onibrow/eecs149-proj/hardware/buck.png

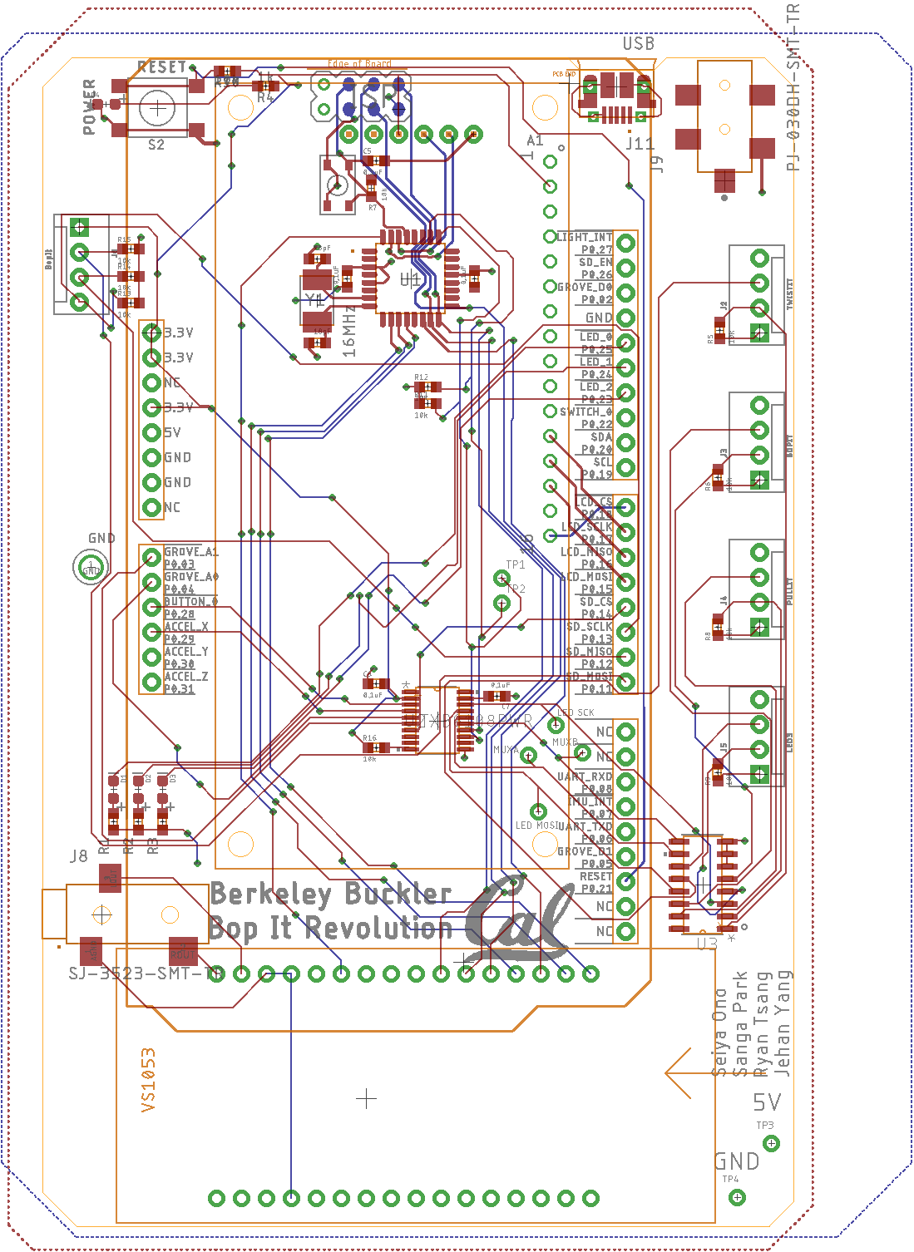
hardware/buck.png
