onibrow/eecs149-proj/hardware/BOM_REV_A.xlsx

Comment | Designator | Footprint | LCSC Part #（optional）
0.1uF | C1, C2, C5, C6, C7 | 0603_C | C14663
18pF | C3, C4 | 0603_C | C1647
10k | R5, R6, R7, R8, R9, R10, R11, R12, R13, R14, R15, R16 | 0603_R | C25804
1k | R1, R2, R3, R4 | 0603_R | C21190
ATMEGA328P | U1 | QFN-44_EP_7x7x0.5P | C14877
Green | D1 | LED_0603 | C72043
Red | D2 | LED_0603 | C2286
Green | D3 | LED_0603 | C72043
Red | D4 | LED_0603 | C2286
