onibrow/eecs149-proj/LED_strip_test/README.md

LED Strip Test
=====

WS2801 LED Strip tests. Currently writing API in order to simplify integration. 
TODO: 
  * Working on muxing between 3 LEDs.
  * Linked list structure used to insert different RGB values at various times for a long song. 

Copied code from SPIM example. 

Reference: SPIM SDK 15.3.0 Driver 
(https://infocenter.nordicsemi.com/topic/com.nordic.infocenter.sdk5.v15.3.0/group__nrfx__spim.html)
