onibrow/eecs149-proj/LED_strip_test/SomeLightsOn.jpg

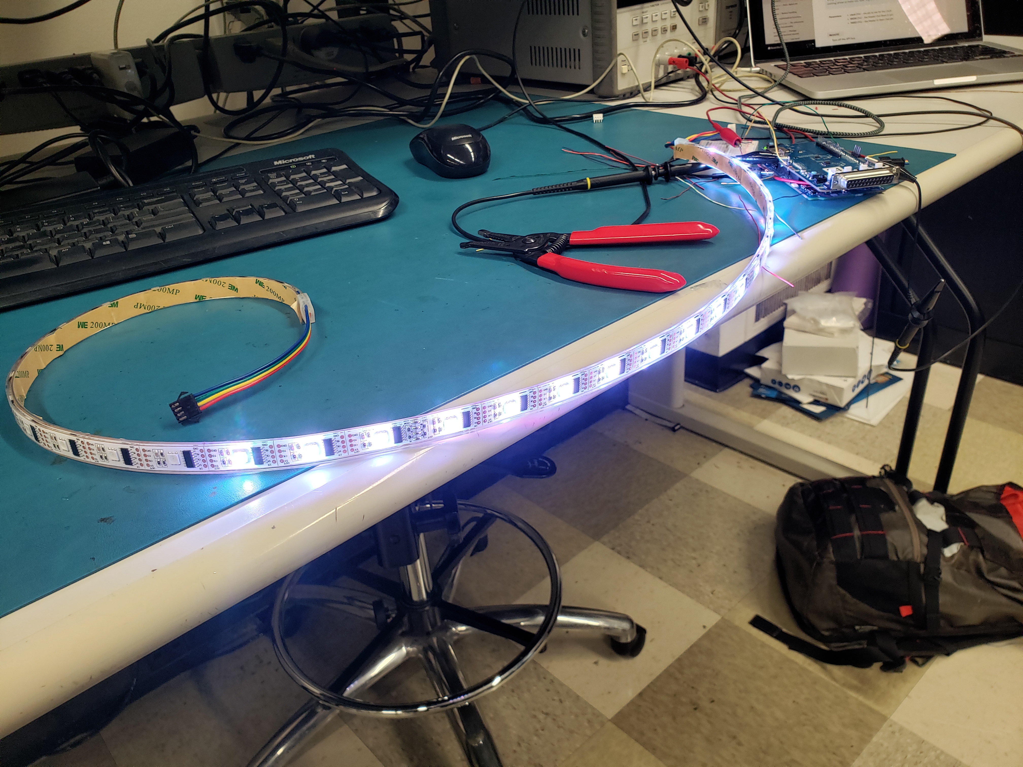
LED_strip_test/SomeLightsOn.jpg
