onibrow/eecs149-proj/hardware/buckler.brd

## EAGLE design hardware/buckler.brd (2019-12-12)

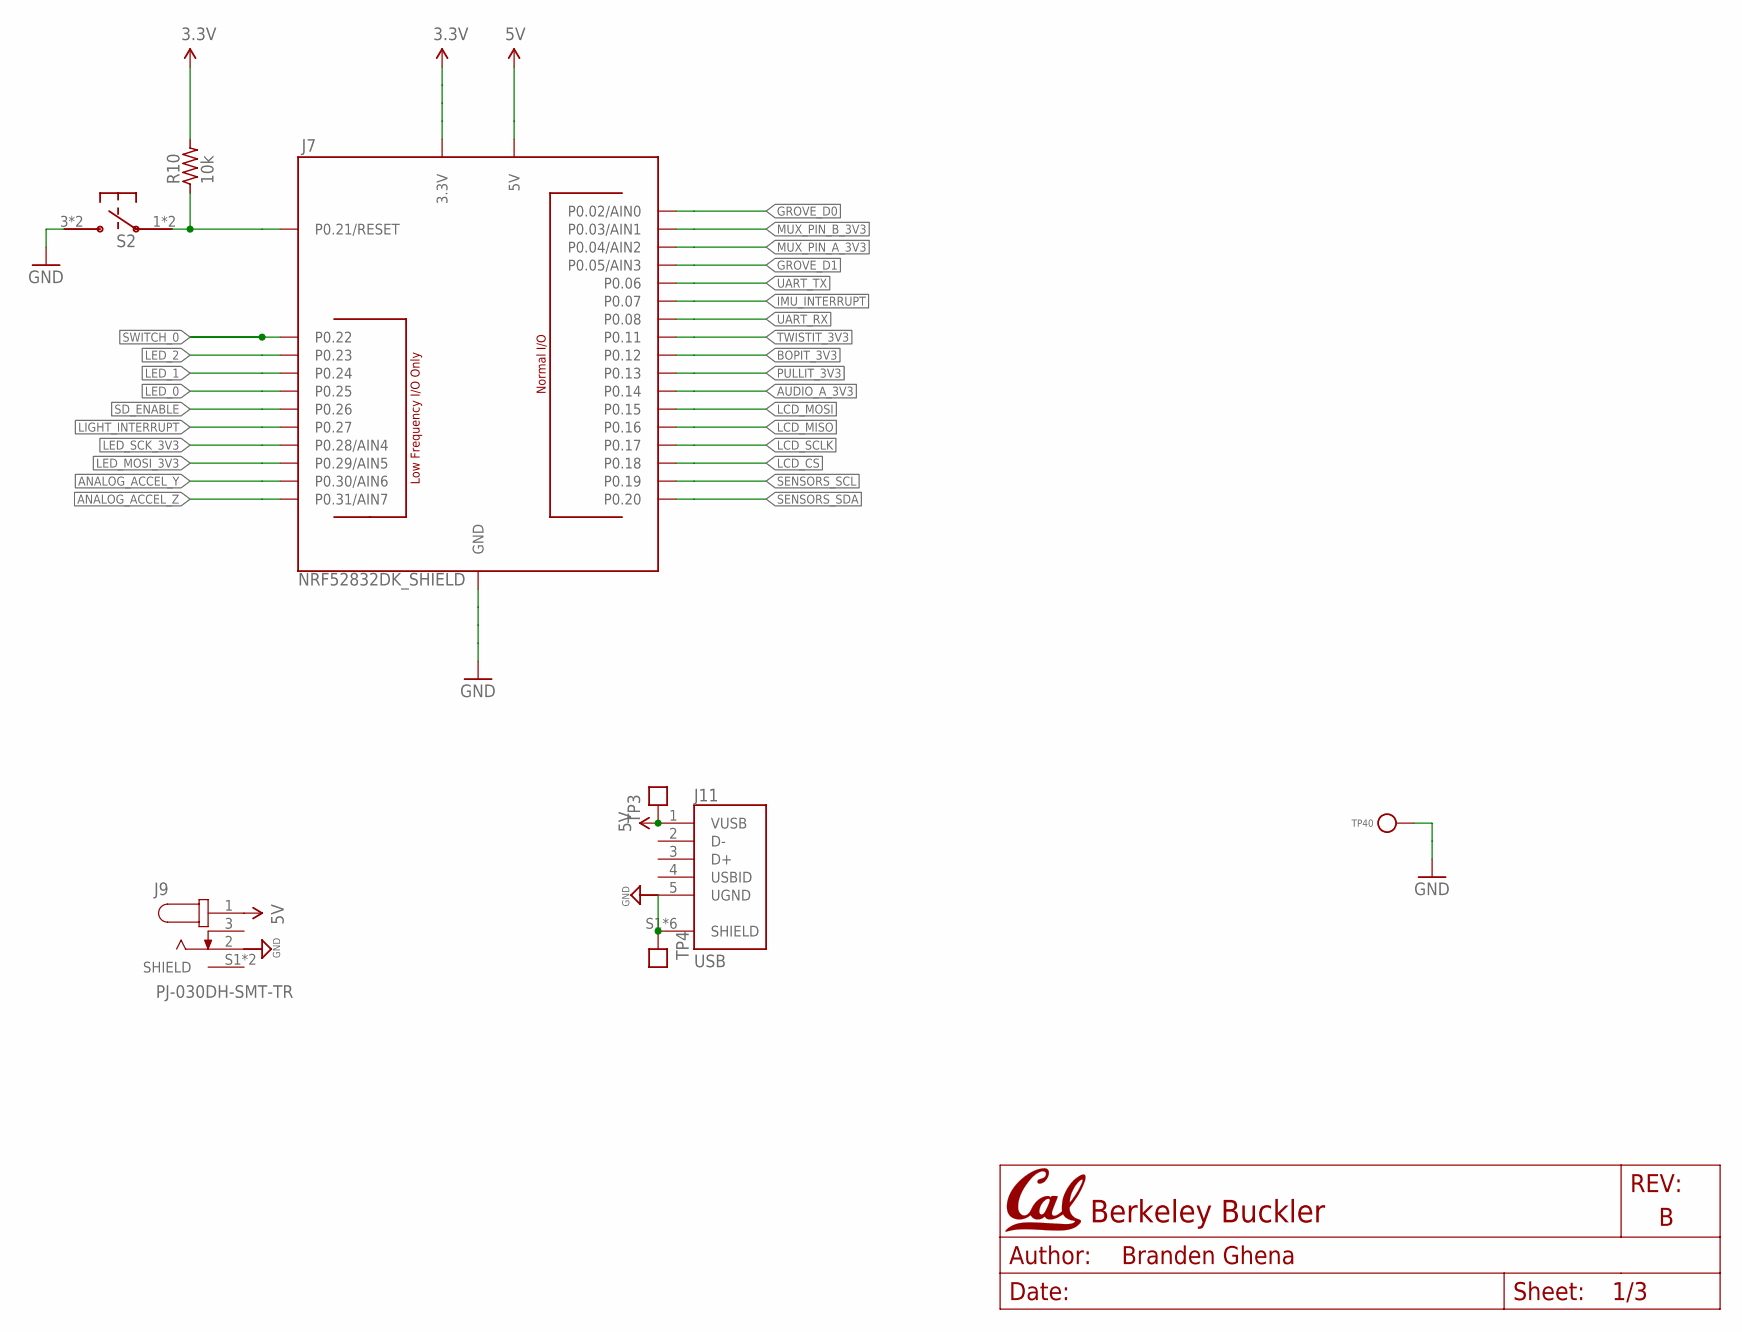
[picture p4: schematic buckler.sch, sheet 1, Headers]

Parts:
J7: NRF52832DK_SHIELD; DIGIKEY1 S1011EC-10-ND
J9: PJ-030DH-SMT-TR; CUI_PJ-030DH-SMT-TR
J11: USB; FCI_10103594-0001LF
R10: 10k; 0603-RES; MPN RC1005F103CS; DIGIKEY 1276-3431-1-ND
S2: PTS645SM43SMTR92; PTS645; MPN PTS645SM43SMTR92 LFS
TP3, TP4: TEST_POINTTHRU; TEST_POINT
TP40: TEST_POINT_0.078IN; TESTPOINT_0.078IN; MPN 1520-2; DIGIKEY 36-1520-2-ND

Connections:
3.3V: J7.3.3V@0 (3.3V), J7.3.3V@1 (3.3V), J7.3.3V@2 (3.3V), R10.2; also elsewhere on the board
5V: J7.5V, J9.1, J11.1 (VUSB), TP3.1; also elsewhere on the board
!IMU_INTERRUPT: J7.P0.07
!LCD_CS: J7.P0.18; also elsewhere on the board
!LED_0: J7.P0.25; also elsewhere on the board
!LED_1: J7.P0.24; also elsewhere on the board
!LED_2: J7.P0.23; also elsewhere on the board
!LIGHT_INTERRUPT: J7.P0.27
!RESET: J7.P0.21 (P0.21/RESET), R10.1, S2.1, S2.2
ANALOG_ACCEL_Y: J7.P0.30 (P0.30/AIN6)
ANALOG_ACCEL_Z: J7.P0.31 (P0.31/AIN7)
AUDIO_A_3V3: J7.P0.14; also elsewhere on the board
BOPIT_3V3: J7.P0.12; also elsewhere on the board
GND: J7.GND@0 (GND), J7.GND@1 (GND), J7.GND@2 (GND), J9.2, J11.5 (UGND), J11.S1 (SHIELD), J11.S2 (SHIELD), J11.S3 (SHIELD), J11.S4 (SHIELD), J11.S5 (SHIELD), J11.S6 (SHIELD), S2.3, S2.4, TP4.1, TP40.1; also elsewhere on the board
GROVE_D0: J7.P0.02 (P0.02/AIN0)
GROVE_D1: J7.P0.05 (P0.05/AIN3)
LCD_MISO: J7.P0.16; also elsewhere on the board
LCD_MOSI: J7.P0.15; also elsewhere on the board
LCD_SCLK: J7.P0.17; also elsewhere on the board
LED_MOSI_3V3: J7.P0.29 (P0.29/AIN5); also elsewhere on the board
LED_SCK_3V3: J7.P0.28 (P0.28/AIN4); also elsewhere on the board
MUX_PIN_A_3V3: J7.P0.04 (P0.04/AIN2); also elsewhere on the board
MUX_PIN_B_3V3: J7.P0.03 (P0.03/AIN1); also elsewhere on the board
PULLIT_3V3: J7.P0.13; also elsewhere on the board
SD_ENABLE: J7.P0.26
SENSORS_SCL: J7.P0.19
SENSORS_SDA: J7.P0.20
SWITCH_0: J7.P0.22
TWISTIT_3V3: J7.P0.11; also elsewhere on the board
UART_RX: J7.P0.08
UART_TX: J7.P0.06

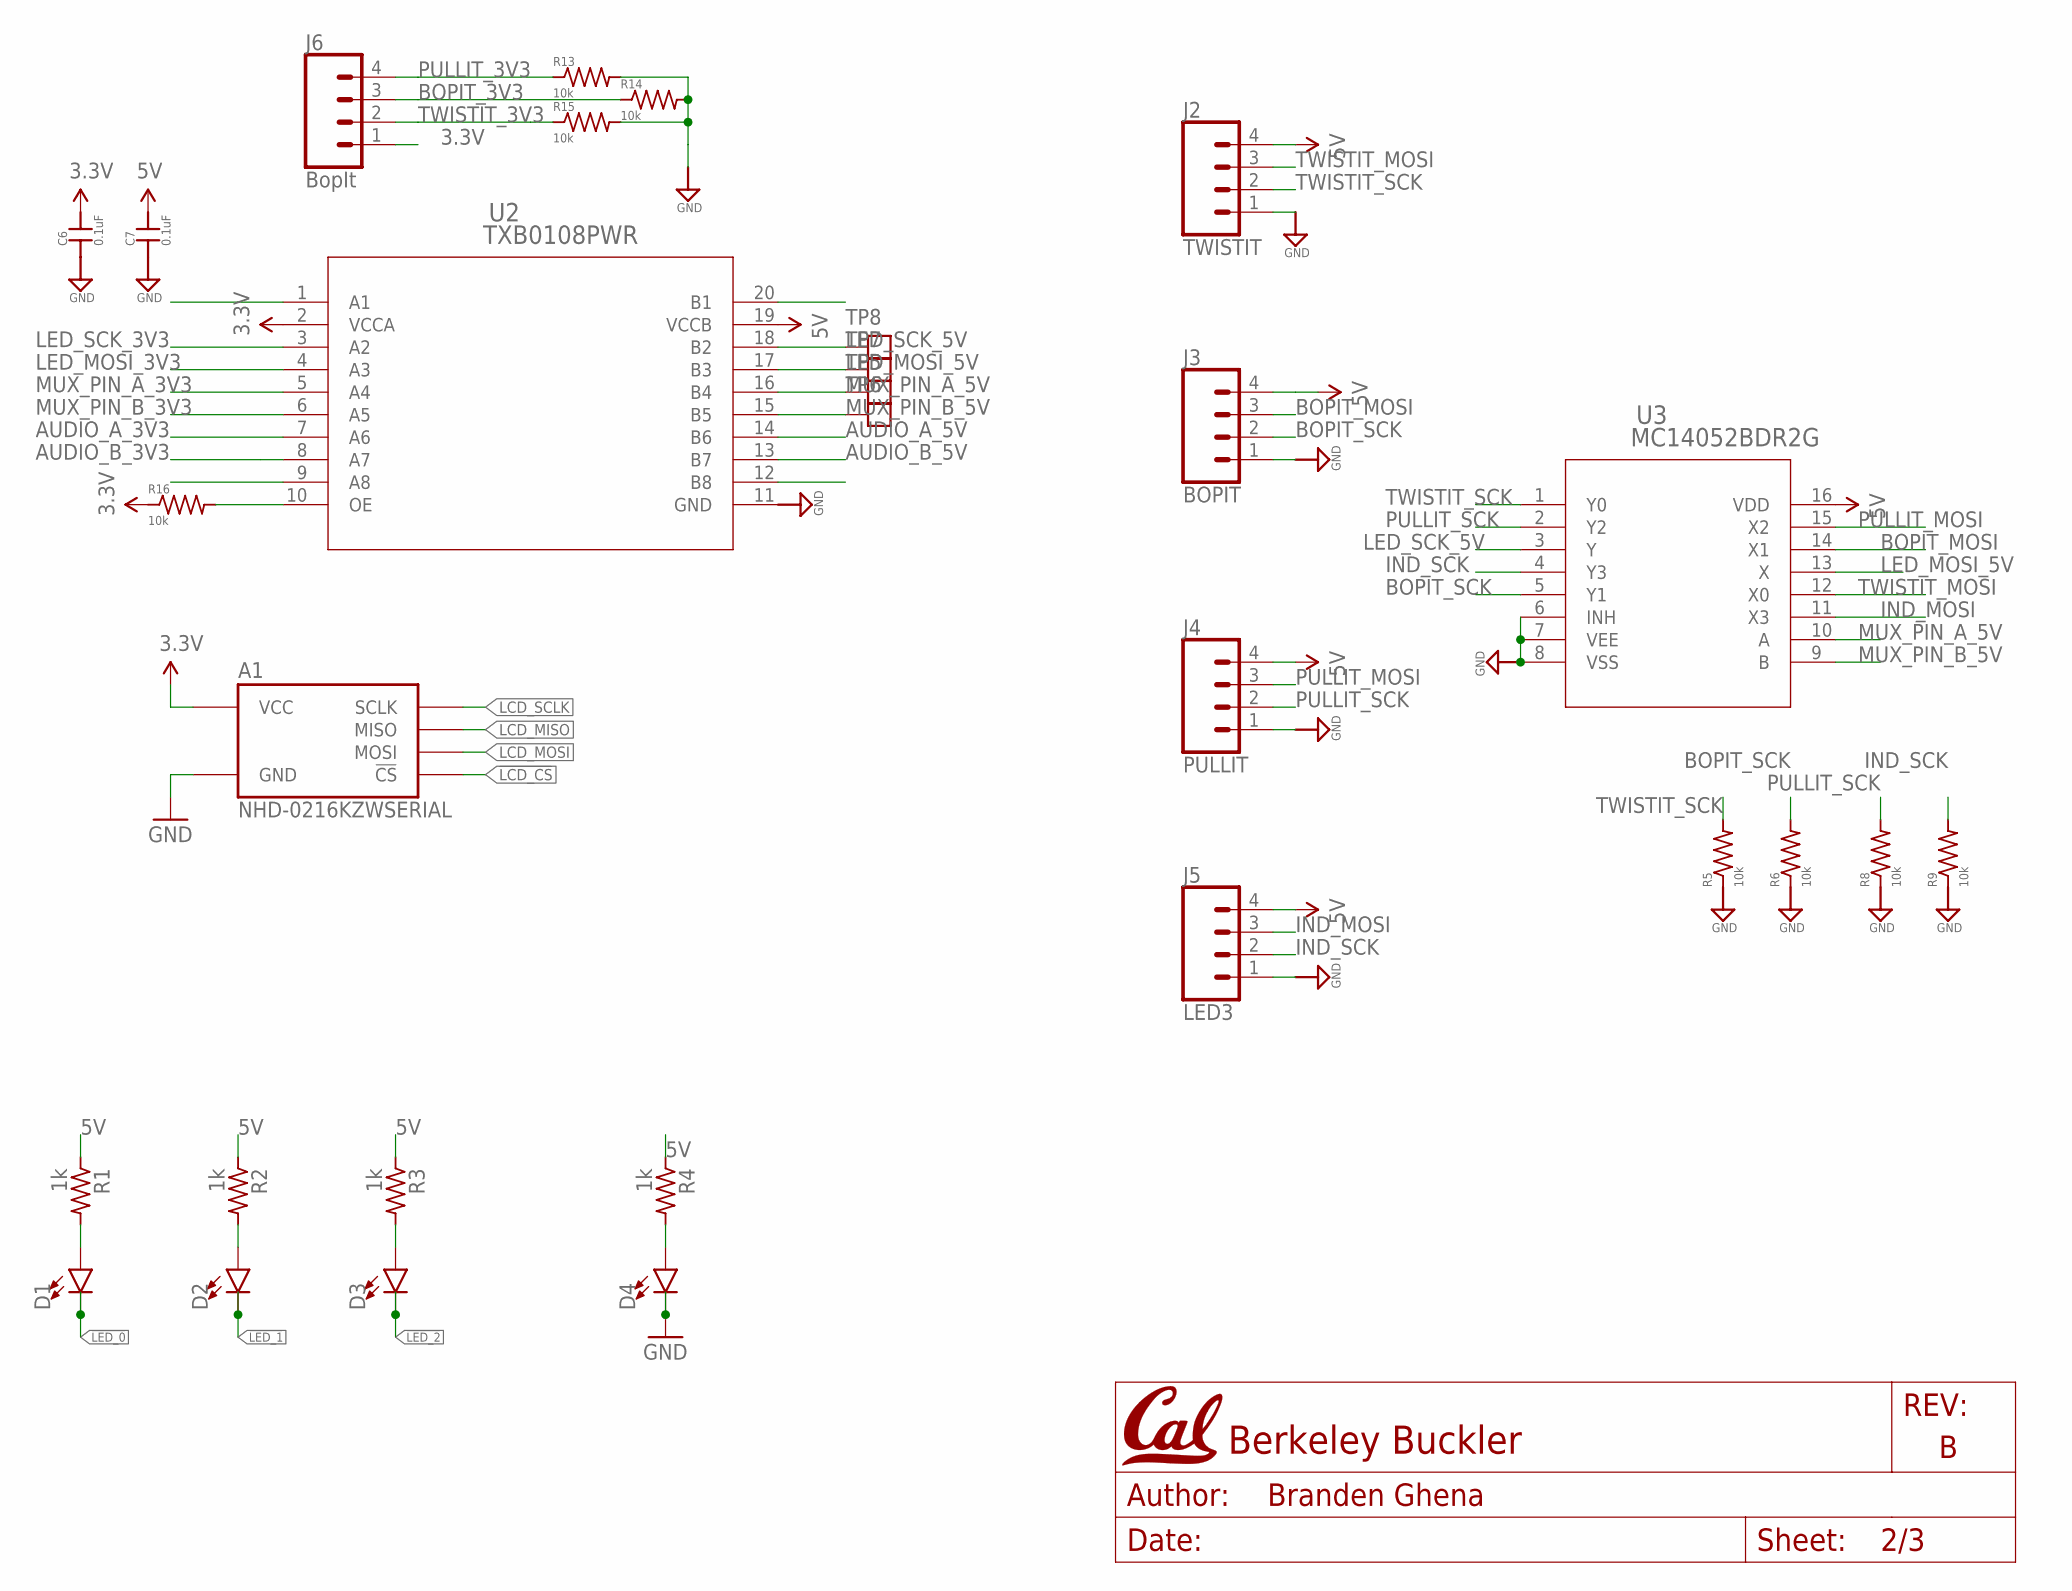
[picture p5: schematic buckler.sch, sheet 2, Other Peripherals]

Parts:
A1: NHD-0216KZWSERIAL; NHD-0216KZW; DIGIKEY1 NHD-0216KZW-AG5-ND
C6, C7: 0.1uF; 0603-CAP
D1, D2, D3, D4: LED0603; LED-0603
J2: TWISTIT; MOLEX-1X4
J3: BOPIT; MOLEX-1X4
J4: PULLIT; MOLEX-1X4
J5: LED3; MOLEX-1X4
J6: BopIt; MOLEX-1X4
R1, R2, R3, R4: 1k; 0603-RES; MPN RMCF0402FT1K00; DIGIKEY RMCF0402FT1K00CT-ND
R5, R6, R8, R9, R13, R14, R15, R16: 10k; 0603-RES
TP5, TP6, TP7, TP8: TEST_POINTTHRU; TEST_POINT
U2: TXB0108PWR; PW20
U3: MC14052BDR2G; SOIC-16

Connections:
3.3V: A1.2 (VCC), C6.2, J6.1, R16.1, U2.2 (VCCA); also elsewhere on the board
5V: C7.2, J2.4, J3.4, J4.4, J5.4, R1.1, R2.1, R3.1, R4.1, U2.19 (VCCB), U3.16 (VDD); also elsewhere on the board
!LCD_CS: A1.16 (!CS); also elsewhere on the board
!LED_0: D1.C; also elsewhere on the board
!LED_1: D2.C; also elsewhere on the board
!LED_2: D3.C; also elsewhere on the board
AUDIO_A_3V3: U2.7 (A6); also elsewhere on the board
AUDIO_A_5V: U2.14 (B6); also elsewhere on the board
AUDIO_B_3V3: U2.8 (A7)
AUDIO_B_5V: U2.13 (B7); also elsewhere on the board
BOPIT_3V3: J6.3, R14.1; also elsewhere on the board
BOPIT_MOSI: J3.3, U3.14 (X1)
BOPIT_SCK: J3.2, R6.2, U3.5 (Y1)
GND: A1.1 (GND), C6.1, C7.1, D4.C, J2.1, J3.1, J4.1, J5.1, R5.1, R6.1, R8.1, R9.1, R13.2, R14.2, R15.2, U2.11 (GND), U3.6 (INH), U3.7 (VEE), U3.8 (VSS); also elsewhere on the board
IND_MOSI: J5.3, U3.11 (X3)
IND_SCK: J5.2, R9.2, U3.4 (Y3)
LCD_MISO: A1.13 (MISO); also elsewhere on the board
LCD_MOSI: A1.14 (MOSI); also elsewhere on the board
LCD_SCLK: A1.12 (SCLK); also elsewhere on the board
LED_MOSI_3V3: U2.4 (A3); also elsewhere on the board
LED_MOSI_5V: TP7.1, U2.17 (B3), U3.13 (X)
LED_SCK_3V3: U2.3 (A2); also elsewhere on the board
LED_SCK_5V: TP8.1, U2.18 (B2), U3.3 (Y)
MUX_PIN_A_3V3: U2.5 (A4); also elsewhere on the board
MUX_PIN_A_5V: TP5.1, U2.16 (B4), U3.10 (A)
MUX_PIN_B_3V3: U2.6 (A5); also elsewhere on the board
MUX_PIN_B_5V: TP6.1, U2.15 (B5), U3.9 (B)
unnamed: R16.2, U2.10 (OE)
unnamed: D4.A, R4.2
unnamed: D3.A, R3.2
unnamed: D2.A, R2.2
unnamed: D1.A, R1.2
PULLIT_3V3: J6.4, R13.1; also elsewhere on the board
PULLIT_MOSI: J4.3, U3.15 (X2)
PULLIT_SCK: J4.2, R8.2, U3.2 (Y2)
TWISTIT_3V3: J6.2, R15.1; also elsewhere on the board
TWISTIT_MOSI: J2.3, U3.12 (X0)
TWISTIT_SCK: J2.2, R5.2, U3.1 (Y0)

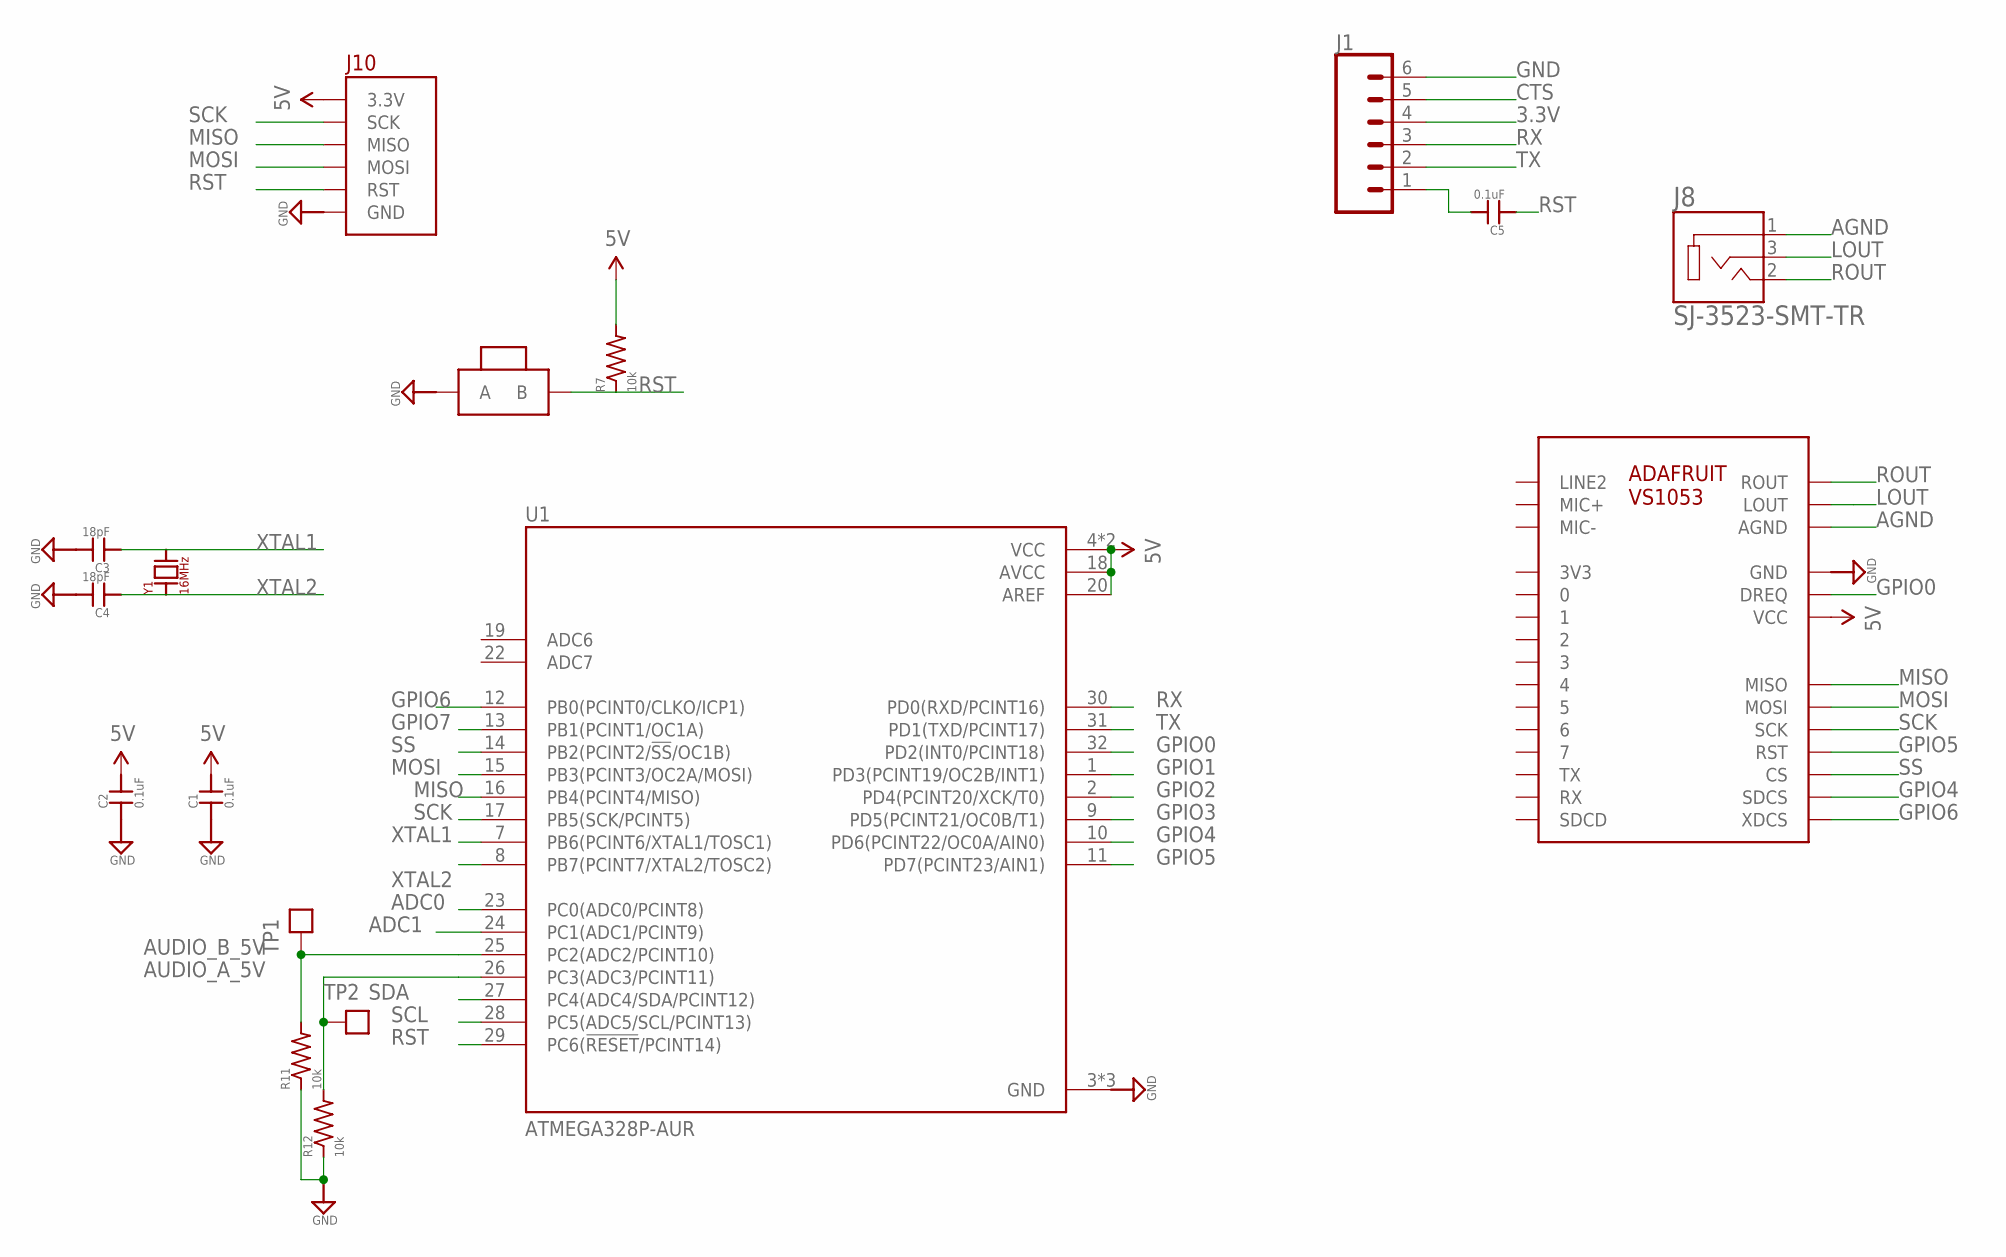
[picture p6: schematic buckler.sch, sheet 3]

Parts:
C1, C2, C5: 0.1uF; 0603-CAP
C3, C4: 18pF; 0603-CAP
J1: CONN_06NO_SILK_FEMALE_PTH; 1X06_NO_SILK
J8: SJ-3523-SMT-TR; CUI_SJ-3523-SMT-TR
J10: BURNIN
R7: 10k; R0603
R11, R12: 10k; 0603-RES
SW1: BTN-PTS810; BTN_PTS810
TP1, TP2: TEST_POINTTHRU; TEST_POINT
U1: ATMEGA328P-AUR; QFP80P900X900X120-32N
U4: ADAFRUIT_VS1053
Y1: 16MHz; XTAL500X320X130N

Connections:
3.3V: J1.4; also elsewhere on the board
5V: C1.2, C2.2, J10.3.3V, R7.2, U1.4 (VCC), U1.6 (VCC), U1.18 (AVCC), U1.20 (AREF), U4.26 (VCC); also elsewhere on the board
ADC0: U1.23 (PC0(ADC0/PCINT8))
ADC1: U1.24 (PC1(ADC1/PCINT9))
AGND: J8.1, U4.4 (AGND), U4.29 (AGND), U4.30 (AGND)
AUDIO_A_5V: R12.2, TP2.1, U1.26 (PC3(ADC3/PCINT11)); also elsewhere on the board
AUDIO_B_5V: R11.2, TP1.1, U1.25 (PC2(ADC2/PCINT10)); also elsewhere on the board
CTS: J1.5
GND: C1.1, C2.1, C3.2, C4.2, J1.6, J10.GND, R11.1, R12.1, SW1.1 (A), SW1.2 (A), U1.3 (GND), U1.5 (GND), U1.21 (GND), U4.24 (GND), U4.28 (GND); also elsewhere on the board
GPIO0: U1.32 (PD2(INT0/PCINT18)), U4.27 (DREQ)
GPIO1: U1.1 (PD3(PCINT19/OC2B/INT1))
GPIO2: U1.2 (PD4(PCINT20/XCK/T0))
GPIO3: U1.9 (PD5(PCINT21/OC0B/T1))
GPIO4: U1.10 (PD6(PCINT22/OC0A/AIN0)), U4.18 (SDCS)
GPIO5: U1.11 (PD7(PCINT23/AIN1)), U4.20 (RST)
GPIO6: U1.12 (PB0(PCINT0/CLKO/ICP1)), U4.17 (XDCS)
GPIO7: U1.13 (PB1(PCINT1/OC1A))
LOUT: J8.3, U4.31 (LOUT)
MISO: J10.MISO, U1.16 (PB4(PCINT4/MISO)), U4.23 (MISO)
MOSI: J10.MOSI, U1.15 (PB3(PCINT3/OC2A/MOSI)), U4.22 (MOSI)
unnamed: C5.2, J1.1
ROUT: J8.2, U4.32 (ROUT)
RST: C5.1, J10.RST, R7.1, SW1.3 (B), SW1.4 (B), U1.29 (PC6(!RESET!/PCINT14))
RX: J1.3, U1.30 (PD0(RXD/PCINT16))
SCK: J10.SCK, U1.17 (PB5(SCK/PCINT5)), U4.21 (SCK)
SCL: U1.28 (PC5(ADC5/SCL/PCINT13))
SDA: U1.27 (PC4(ADC4/SDA/PCINT12))
SS: U1.14 (PB2(PCINT2/!SS!/OC1B)), U4.19 (CS)
TX: J1.2, U1.31 (PD1(TXD/PCINT17))
XTAL1: C3.1, U1.7 (PB6(PCINT6/XTAL1/TOSC1)), Y1.2 (B)
XTAL2: C4.1, U1.8 (PB7(PCINT7/XTAL2/TOSC2)), Y1.1 (A)

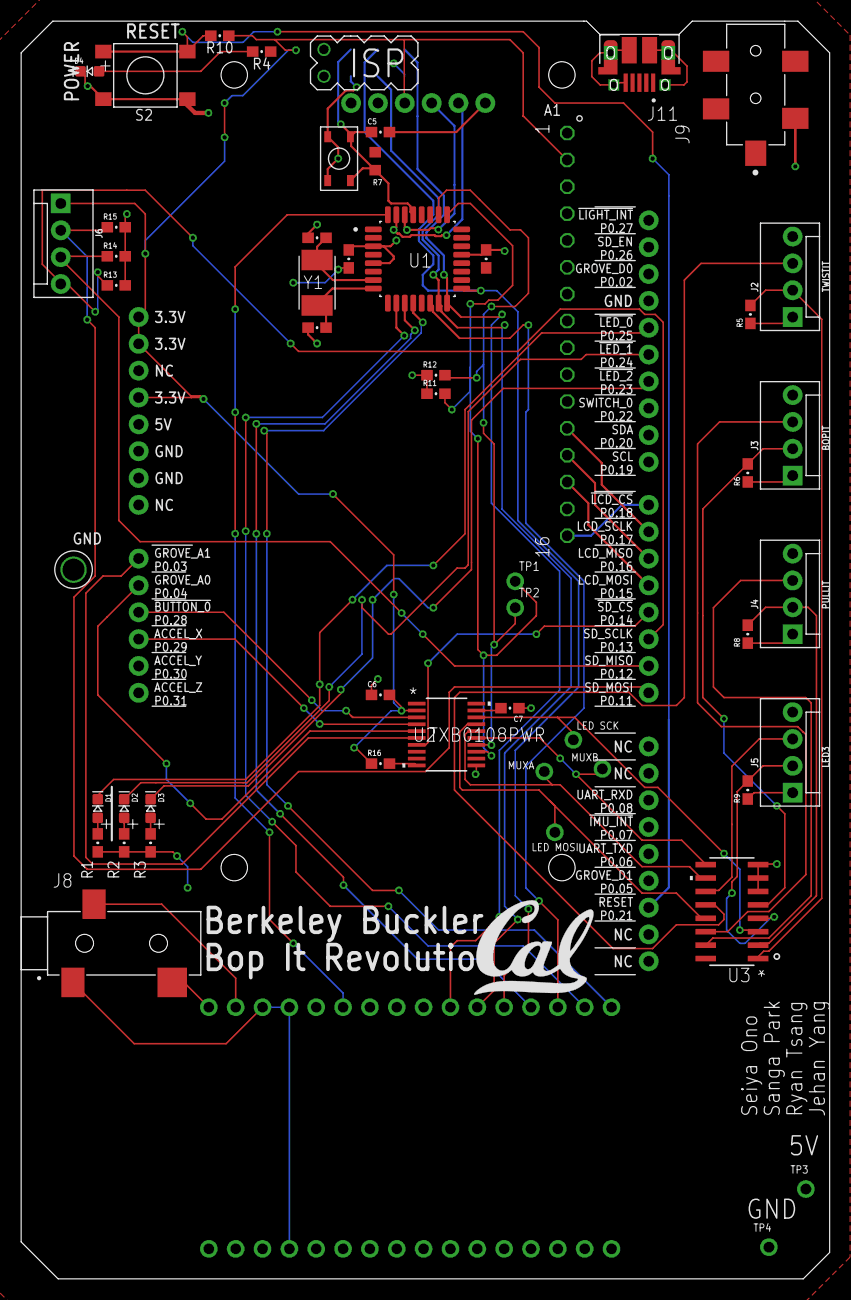
[picture p7: board buckler.brd from above]

Board: 2 copper layers, 76.5 x 119.0 mm, 56 parts (0 on the bottom side), 55 nets.

Other parts of the board:
U$5: UCB_CAL_350MIL
