onibrow/eecs149-proj/vm_setup/app_config.h

// application-specific configuration
// augments the base configuration in sdk/<SDK>/config/<IC>/config/sdk_config.h

#pragma once

#define SIMPLE_BLE_ENABLED 1

#define BLE_ADVERTISING_ENABLED 1
#define NRF_BLE_CONN_PARAMS_ENABLED 1
#define NRF_BLE_GATT_ENABLED 1
#define NRF_BLE_QWR_ENABLED 1
#define BLE_ECS_ENABLED 1

#define BLE_LBS_ENABLED 1
#define BLE_NUS_ENABLED 1

#define NRF_CRYPTO_BACKEND_CIFRA_ENABLED 1
#define NRF_CRYPTO_BACKEND_MBEDTLS_ENABLED 1
#define NRF_CRYPTO_BACKEND_NRF_HW_RNG_ENABLED 1

#define GPIOTE_ENABLED 1
#define GPIOTE_CONFIG_NUM_OF_LOW_POWER_EVENTS 4
#define NRFX_GPIOTE_ENABLED 1

#define NRFX_RNG_ENABLED 1
#define RNG_ENABLED 1

#define NRFX_SAADC_ENABLED 1
#define SAADC_ENABLED 1
#define SAADC_CONFIG_LP_MODE 1

#define NRFX_SPIM_ENABLED 1
#define NRFX_SPIM1_ENABLED 1
#define NRFX_SPI_ENABLED 1
#define NRFX_SPI1_ENABLED 1
#define SPI_ENABLED 1
#define SPI1_ENABLED 1

#define APP_SDCARD_ENABLED 1
#define APP_SDCARD_SPI_INSTANCE 2 // added 
//APP_SDCARD_FREQ_INIT later 

#define NRF_CLOCK_ENABLED 1
#define NRFX_CLOCK_ENABLED 1

#define NRFX_TIMER_ENABLED 1
#define NRFX_TIMER0_ENABLED 1
#define NRFX_TIMER1_ENABLED 1
#define TIMER_ENABLED 1
#define TIMER_DEFAULT_CONFIG_BIT_WIDTH 3
#define TIMER0_ENABLED 1
#define TIMER1_ENABLED 1
#define APP_TIMER_ENABLED 1
#define APP_TIMER_KEEPS_RTC_ACTIVE 1

#define NRFX_UARTE_ENABLED 1
#define NRFX_UART_ENABLED 1
#define UART_ENABLED 1
#define UART0_ENABLED 1
#define APP_UART_ENABLED 1
#define HCI_UART_TX_PIN 6
#define HCI_UART_RX_PIN 8

#define NRFX_TWIM_ENABLED 0  //change it to 1, changed for sd card for now 
#define NRFX_TWI_ENABLED 0
#define TWI_ENABLED 0
#define TWI0_ENABLED 1
#define TWI0_USE_EASY_DMA 1
#define NRF_TWI_MNGR_ENABLED 0

#define APP_FIFO_ENABLED 1
#define APP_SCHEDULER_ENABLED 1

#define CRC16_ENABLED 1

#define NRF_FSTORAGE_ENABLED 1
#define FDS_ENABLED 1
#define FDS_VIRTUAL_PAGES 10
#define FDS_OP_QUEUE_SIZE 10

#define MEM_MANAGER_ENABLED 1

#define NRF_QUEUE_ENABLED 1

#define NRF_PWR_MGMT_ENABLED 1
#define NRF_PWR_MGMT_CONFIG_FPU_SUPPORT_ENABLED 1

#define RETARGET_ENABLED 0

#define BUTTON_ENABLED 1

#define NRFX_PWM_ENABLED 1
#define NRFX_PWM0_ENABLED 1
#define NRFX_PWM1_ENABLED 1
#define NRFX_PWM2_ENABLED 1
#define PWM_ENABLED 1
#define PWM0_ENABLED 1
#define PWM1_ENABLED 1
#define PWM2_ENABLED 1
#define APP_PWM_ENABLED 1
#define LOW_POWER_PWM_ENABLED 1
#define NRFX_PPI_ENABLED 1
#define PPI_ENABLED 1

#define NRF_SECTION_ITER_ENABLED 1

#define NRF_LOG_ENABLED 1
#define NRF_LOG_BACKEND_UART_ENABLED 0
#define NRF_LOG_BACKEND_RTT_ENABLED 1
#define NRF_LOG_USES_RTT 1
#define NRF_LOG_DEFERRED 0
#define NRF_LOG_STR_PUSH_BUFFER_SIZE 128

#define HARDFAULT_HANDLER_ENABLED 1
#define HARDFAULT_HANDLER_GDB_PSP_BACKTRACE 0

#define NRF_SERIAL_ENABLED 1

#define NRF_SDH_ENABLED 1
#define NRF_SDH_BLE_ENABLED 1
#define NRF_SDH_BLE_GAP_DATA_LENGTH 251
#define NRF_SDH_BLE_PERIPHERAL_LINK_COUNT 1
#define NRF_SDH_BLE_GATT_MAX_MTU_SIZE 247
#define NRF_SDH_BLE_VS_UUID_COUNT 10
#define NRF_SDH_SOC_ENABLED 1

// GROUP DEFINED CONFIGS
#define TWI_INSTANCE_ID_USED 0
#define I2S_ENABLED 1
#define NRFX_I2S_ENABLED 1
#define MCP4725_BASE_ADDRESS    0x62        //!< MCP4725 base address

//#define NRFX_SPI_INSTANCE 1
//#define NRFX_SPI_INSTANCE_ID 1
//#define NRF_DRV_SPI_INSTANCE 2

// lots of redundancy, solves not-finding-instance in nrf_drive_spi error 
#define NRFX_SPIM_ENABLED 1
#define NRFX_SPIM0_ENABLED 1
#define NRFX_SPI_ENABLED 1
#define NRFX_SPI0_ENABLED 1
#define SPI_ENABLED 1
#define SPI0_ENABLED 1

//#define NRFX_SPIM_ENABLED 1
#define NRFX_SPIM2_ENABLED 1
#define NRFX_SPI2_ENABLED 1
#define SPI2_ENABLED 1
