onibrow/eecs149-proj/(commit log)

2019-11-08 Add voltage comands
2019-11-14 Fix board mk
2019-11-18 Add includes file and fix sd card pins
    [main.c]
2019-11-18 Add timer
2019-11-20 resolved wrong directory - not compiling issue for SD Card
    [app_config.h]
2019-11-20 SD card now reads, but buffer offset issue exists
    [main.c]
2019-11-20 SD card now reads, but buffer offset issue exists, also TWI disabled
    [app_config.h]
2019-11-21 Added LEDCode Folder with all relevent LED/SPI files
2019-12-05 fix sd card merge conflict
    [LEDStripAPI.c, LEDStripAPI.h, main.c]
2019-12-05 fix sd card conflict
    [main.c]
2019-12-05 clean up code a bit ad fix lsb msb nonsense
    [main.c]
2019-12-05 LED API Works, lightly tested, have not checked for memory leaks
    [LEDStripAPI.c, LEDStripAPI.h, main.c]
2019-12-05 Rewrote API that doesn't use linked list and added MUX support. Untested
    [LEDStripAPI.c, main.c, oldLEDAPI.c, oldLEDAPI.h]
2019-12-05 Forgot to initialize gpio pins for mux. fixed and compiles. still untested.
    [LEDStripAPI.c]
2019-12-05 API tested and fixed.
    [LEDStripAPI.c, main.c]
2019-12-05 Added a debugging function: printState()
2019-12-05 3rd LED Strip Added, colors picked, pull down resistors added
2019-12-05 integration of led and bpm
2019-12-05 more progress on led speed
2019-12-12 Finish the board
    [BOM_REV_A.xlsx, buckler.brd, buckler.sch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]
2019-12-13 What Ive Done and Derezzed added and sync'd. minor bugs
    [main.c]
2019-12-17 fix timings of songs and add loading screen
    [main.c]
