onibrow/eecs149-proj/(notices)

Notices in the files:
parts and their libraries:
scono: COPYRIGHT: Copyright (C) 2016 Accelerated Designs. All rights reserved
